Juventus-Technikerschule-HF/EduboardV2_Baseboard/3DModel/Eduboard2_CPUClip_V3.stl

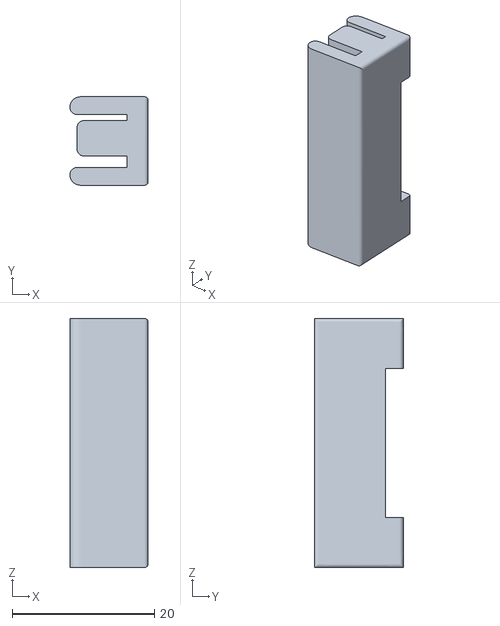
[picture p1: CAD file, 2023-07-14]
3DModel/Eduboard2_CPUClip_V3.stl
11.0 x 12.5 x 35.0
