Juventus-Technikerschule-HF/EduboardV2_Baseboard/3DModel/Eduboard2_CPUClamp1_V1.stl

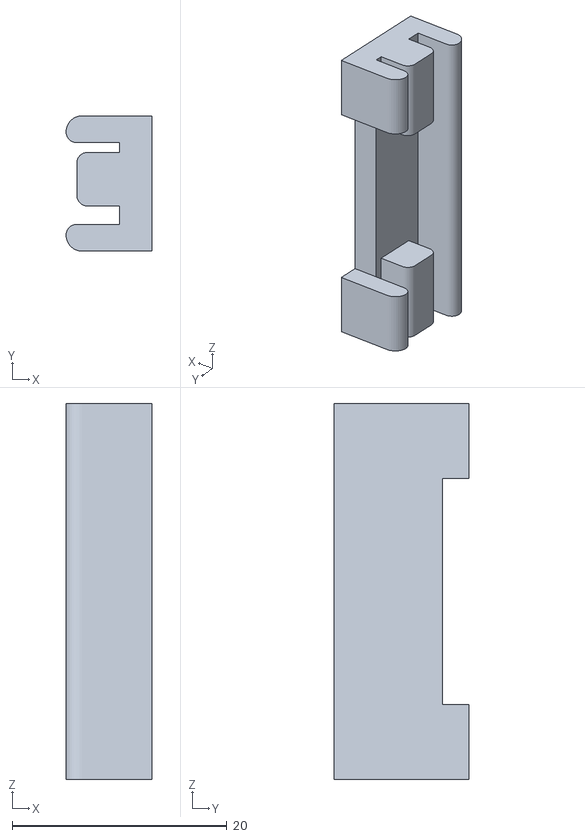
[picture p2: CAD file, 2023-07-14]
3DModel/Eduboard2_CPUClamp1_V1.stl
8.00 x 12.6 x 35.0
