Juventus-Technikerschule-HF/EduboardV2_Baseboard/3DModel/Edubaord2_CPUClip_V2.stl

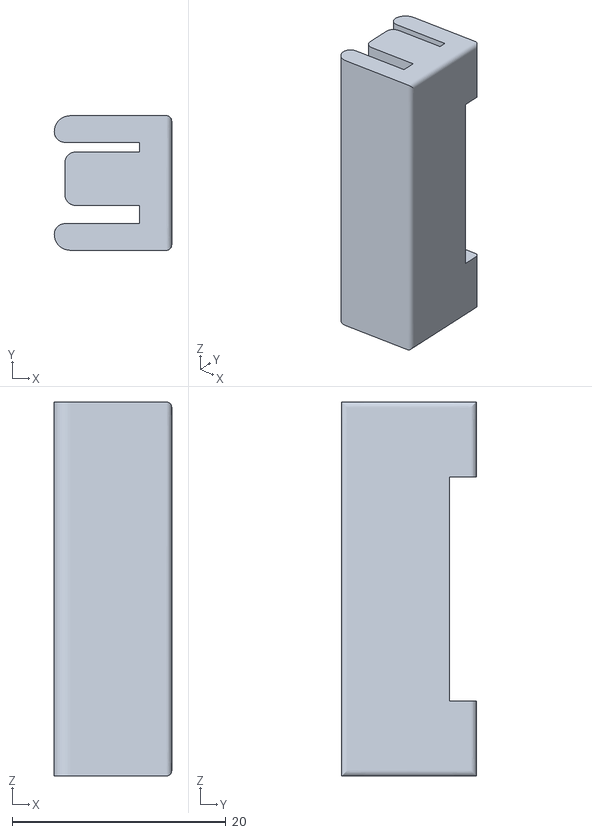
[picture p3: CAD file, 2023-07-14]
3DModel/Edubaord2_CPUClip_V2.stl
11.0 x 12.6 x 35.0
