Juventus-Technikerschule-HF/EduboardV2_Baseboard/3DModel/Eduboard2_Display3.5Clip_V2.stl

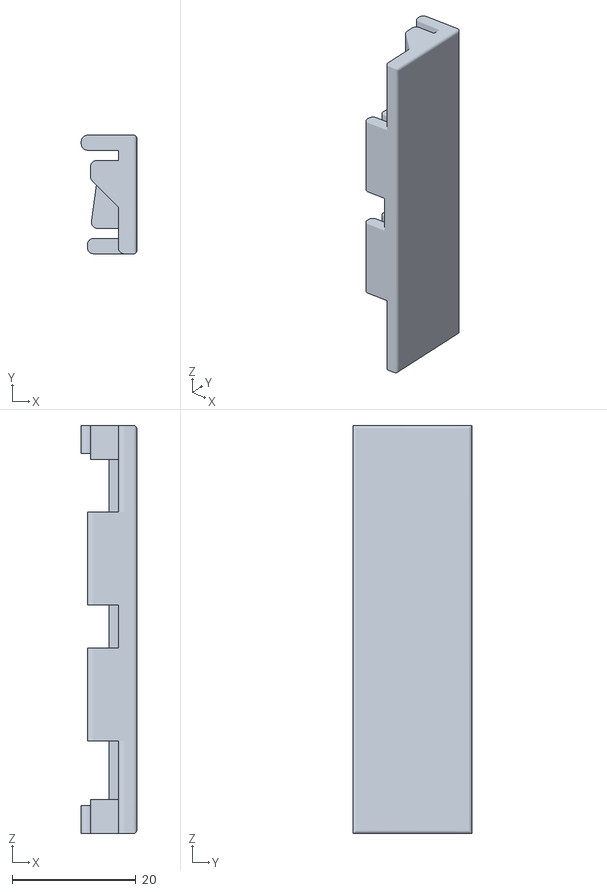
[picture p4: CAD file, 2023-07-14]
3DModel/Eduboard2_Display3.5Clip_V2.stl
9.00 x 19.2 x 66.0
