Juventus-Technikerschule-HF/EduboardV2_Baseboard/3DModel/Eduboard_Adapter.step

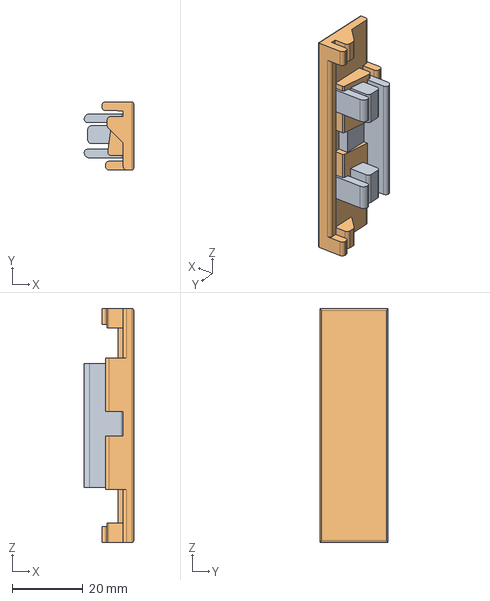
[picture p5: CAD file, 2023-07-14]
3DModel/Eduboard_Adapter.step
14.0 x 19.2 x 66.0 mm
CPUClip
Display3.5Clip
