Juventus-Technikerschule-HF/EduboardV2_Baseboard/3DModel/Eduboard2_Display3.5Clip_V1.stl

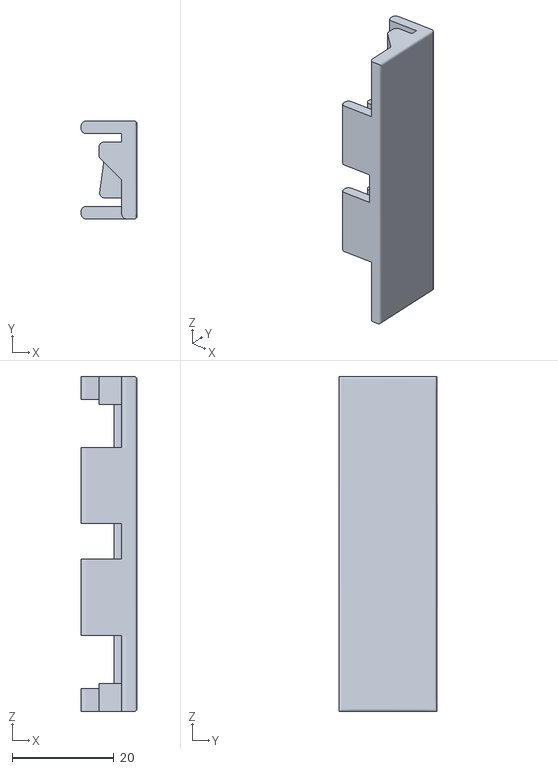
[picture p6: CAD file, 2023-07-14, an earlier design]
3DModel/Eduboard2_Display3.5Clip_V1.stl
11.0 x 19.3 x 66.0
