Juventus-Technikerschule-HF/EduboardV2_Baseboard/usbhub.kicad_sch

## KiCad design usbhub.kicad_sch (2024-07-12, an earlier design)

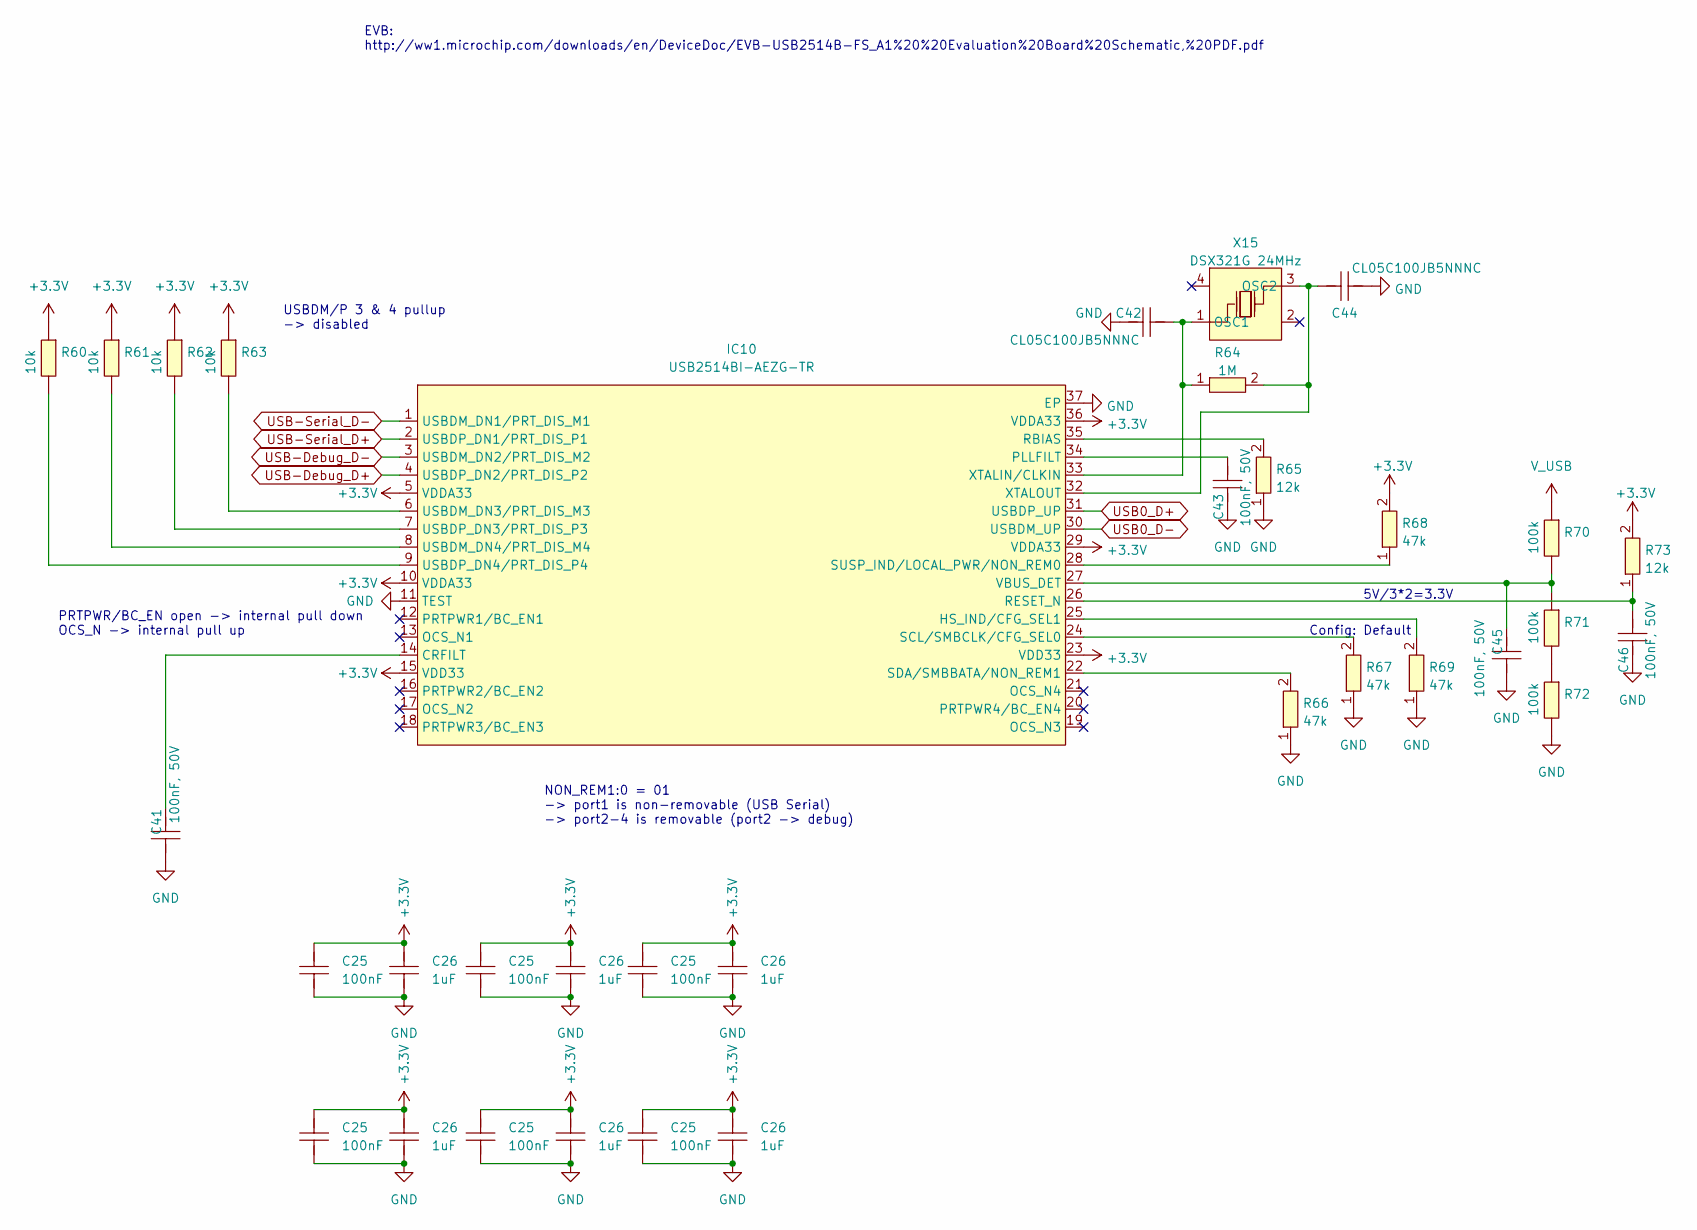
[picture p7: schematic usbhub.kicad_sch]

Parts:
C25: 100nF; C_0402_1005Metric_Pad0.74x0.62mm_HandSolder; MPN CL05B104KB54PNC; LCSC Part C307331
C26: 1uF; C_0402_1005Metric_Pad0.74x0.62mm_HandSolder; MPN CL05A105KA5NQNC; LCSC Part C52923
C41, C43, C45, C46: 100nF, 50V; C_0402_1005Metric_Pad0.74x0.62mm_HandSolder; MPN CL05B104KB54PNC; LCSC Part C307331
C42, C44: CL05C100JB5NNNC; C_0402_1005Metric_Pad0.74x0.62mm_HandSolder; MPN CL05C100JB5NNNC; LCSC Part C32949
IC10: USB2514BI-AEZG-TR; TQFN-36_L6.0-W6.0-P0.50-BL-EP3.7; MPN USB2514BI-AEZG-TR; LCSC Part C58940
R60, R61, R62, R63: 10k; R_0402_1005Metric_Pad0.72x0.64mm_HandSolder; MPN 0402WGF1002TCE; LCSC Part C25744
R64: 1M; R_0402_1005Metric_Pad0.72x0.64mm_HandSolder; LCSC Part C25741
R65, R73: 12k; R_0402_1005Metric_Pad0.72x0.64mm_HandSolder; LCSC Part C25752
R66, R67, R68, R69: 47k; R_0402_1005Metric_Pad0.72x0.64mm_HandSolder; LCSC Part C25792
R70, R71, R72: 100k; R_0402_1005Metric_Pad0.72x0.64mm_HandSolder; MPN 0402WGF1003TCE; LCSC Part C25741
X15: DSX321G 24MHz; OSC-SMD_4P-L3.2-W2.5-BL; LCSC Part C93235

Connections:
+3.3V: C25.2, C26.2, IC10.5 (VDDA33), IC10.10 (VDDA33), IC10.15 (VDD33), IC10.23 (VDD33), IC10.29 (VDDA33), IC10.36 (VDDA33), R60.1, R61.1, R62.1, R63.1, R68.2, R73.2
GND: C25.1, C26.1, C41.2, C42.1, C43.2, C44.2, C45.2, C46.2, IC10.11 (TEST), IC10.37 (EP), R65.1, R66.1, R67.1, R69.1, R72.2
unnamed: C41.1, IC10.14 (CRFILT)
unnamed: C42.2, IC10.33 (XTALIN/CLKIN), R64.1, X15.1 (OSC1)
unnamed: C43.1, IC10.34 (PLLFILT)
unnamed: C44.1, IC10.32 (XTALOUT), R64.2, X15.3 (OSC2)
unnamed: C45.1, IC10.27 (VBUS_DET), R70.2, R71.1
unnamed: C46.1, IC10.26 (RESET_N), R73.1
unnamed: IC10.6 (USBDM_DN3/PRT_DIS_M3), R63.2
unnamed: IC10.7 (USBDP_DN3/PRT_DIS_P3), R62.2
unnamed: IC10.8 (USBDM_DN4/PRT_DIS_M4), R61.2
unnamed: IC10.9 (USBDP_DN4/PRT_DIS_P4), R60.2
unnamed: IC10.22 (SDA/SMBBATA/NON_REM1), R66.2
unnamed: IC10.24 (SCL/SMBCLK/CFG_SEL0), R67.2
unnamed: IC10.25 (HS_IND/CFG_SEL1), R69.2
unnamed: IC10.28 (SUSP_IND/LOCAL_PWR/NON_REM0), R68.1
unnamed: IC10.35 (RBIAS), R65.2
unnamed: R71.2, R72.1
USB0_D+: IC10.31 (USBDP_UP)
USB0_D-: IC10.30 (USBDM_UP)
USB-Debug_D+: IC10.4 (USBDP_DN2/PRT_DIS_P2)
USB-Debug_D-: IC10.3 (USBDM_DN2/PRT_DIS_M2)
USB-Serial_D+: IC10.2 (USBDP_DN1/PRT_DIS_P1)
USB-Serial_D-: IC10.1 (USBDM_DN1/PRT_DIS_M1)
V_USB: R70.1

Notes on the sheet:
PRTPWR/BC_EN open -> internal pull down OCS_N -> internal pull up
EVB: http://ww1.microchip.com/downloads/en/DeviceDoc/EVB-USB2514B-FS_A1%20%20Evaluation%20Board%20Schematic,%20PDF.pdf
5V/3*2=3.3V
Config: Default
USBDM/P 3 & 4 pullup -> disabled
NON_REM1:0 = 01 -> port1 is non-removable (USB Serial) -> port2-4 is removable (port2 -> debug)
