Juventus-Technikerschule-HF/EduboardV2_Baseboard/(threads)

Thread 3 (2022-06-07):

Move USB Serial Converter and USB Connector from Power Page to Page5 / Page 6

mburger82, 2022-06-07:
CH340 needs to move to Page 6 (interfaces).
USB Connector may be a point to discuss...

mburger82, 2022-06-11:
10b4307024bcba9a6965f9aedea9f77992894b67

Closed 2022-06-11.

Thread 4 (2022-06-07):

replace 5V selector with more fancy (less Voltage drop) circuit

mburger82, 2022-06-07:
Maybe something like this?
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

mburger82, 2022-06-11:
done in 4a000bc18bebc424a0765db95a3bd588f8fbd9e8

Closed 2022-06-11.

Thread 8 (2022-06-07):

Add Ouput Connector to WS2812 Dout

mburger82, 2022-06-07:
5V-Data-GND
Simple 2.54mm 3Pin Solderpads

mburger82, 2022-06-11:
done in 10d15726495d8792da39d1d4b9824ec2d829a732

Closed 2022-06-11.

Thread 11 (2022-06-11):

Switch out +3.3V, +5V, +5V_EXT, V_EXT, V_USB and GND Symbols to References. Otherwise they dont connect the nets.

mburger82, 2022-06-11:

mburger82, 2022-06-11:
Hm, strange. As far as I can see the Symbols should be Correct...
Have to investigate further.

mburger82, 2022-06-11:
fixed in f38e4da2e638162e9049911122649460d996020f

Power References have to be Power-Input Pins. Power-Output does not connect them under one Net-Signal

Closed 2022-06-11.

Thread 14 (2023-05-13):

LCD Connector wrong way round

mburger82, 2023-05-13:
Pin1 -> Pin39
Pin2 -> Pin40

Drawing of LCD is upside down

Thread 15 (2023-05-13):

Thicken tracks for Power

mburger82, 2023-05-13:
Measurements of Voltage Regulators showed, they work very well. But over the length of the tracks the voltage gets lover up to 0.5V at higher currents. Need to thicken them and have multiple Vias on layer changes.

mburger82, 2023-06-22:
The automatic power selector seams to do something weird. Have to investigate.

mburger82, 2023-06-22:
Well... Voltage drop comes from mosfet RDSOn @ 80mOhm or so. At 1A this results in quite some Voltage.
Good enough!

Closed 2023-06-22.

Thread 16 (2023-05-13):

Need Pullups for CS Pins when no UP Board is present

mburger82, 2023-05-13:
When no UP-Board is present or the CS-Pins on the up-board are not configured, the cs Pins should be pulled high anyway to prevent reaction of any SPI Devices on board.

mburger82, 2023-05-28:
Also add pulldowns for pwm channels

mburger82, 2023-06-20:
done in 92582a20dd4010fd6c4107caee330f88c9490ec5 and f3cb5bdc9a72a360fb9439e9020d9e4d49971171

Closed 2023-06-20.

Thread 19 (2023-05-18):

Add DAC unit connected to SPI or I2C to achive basic DAC Options. Possibly multiple outputs

mburger82, 2023-05-18:
I2S is not really an option, because it uses all the GPIOX Pins

mburger82, 2023-05-18:
Could use DAC5571IDBVR (LCSC: C24061)
8Bit I2C DAC capable up to 188 ksps @ 3.4MBit I2C Rate

mburger82, 2023-06-20:
added in 9fb1e6c

Closed 2023-06-20.

Thread 20 (2023-05-18):

Change Holesize of Pads in X6 to something more reasonable like 1mm

mburger82, 2023-05-18:
also probably make pads larger...

mburger82, 2023-06-20:
fix in 5945c712176ba1562dcde1205969f2bf0daca017

Closed 2023-06-20.

Thread 21 (2023-05-18):

Lower I2C Pullups

mburger82, 2023-05-18:
10k Pullups for I2C are way too high for such long lines and so many slaves. Have to lower it to a max of 1k probably.
Have to test that first.

mburger82, 2023-05-27:
1k is way better.
Also change T7 and T8 to BSN20. Way lower Capacitance, which was the main Problem beforehand.
With 1k and BSN20 the Temperature Sensor is working up to 1MHz

mburger82, 2023-06-20:
fixed in 425ff3c

Closed 2023-06-20.

Thread 23 (2023-05-28):

UP Connector 3.3V and 5V need Ideal Diodes to prevent powering from the UP Board when SW1 is off

mburger82, 2023-05-28:

mburger82, 2023-05-29:
Probably not nescessary if no USB is placed on the UP Board at all. Maybe the better option!

mburger82, 2023-06-20:
Not nescessary. USB Connectors on UPBoard should not be present, so not nescessary.

Closed 2023-06-20.

Thread 24 (2023-05-29):

Maybe turn around SW1 90deg to prevent Shipping problems from Prototypes

mburger82, 2023-05-29:

mburger82, 2023-06-22:
done in 33dacbfd15503772adc866fcdd3823dfb586aeab

Closed 2023-06-22.

Thread 25 (2023-07-13):

Move DAC closer to UP or I2C Pullups closer to DAC.

mburger82, 2023-07-13:
If higher I2C Clocks should be achieveable, the capacitive load on the i2c line should be minimized and the length to the dac schould be minimized. Also moving the I2C Pullups closer to the DAC could help.
Maybe make Level-Shifter detachable (Solder Jumpers or somthing like that) to detach cpacity of Level Shifter.

mburger82, 2023-10-30:
obsolete. Replaced with SPI Variant
853b78f0c907125e6715c78b12bc7a0b2f8ac236

Closed 2023-10-30.

Thread 26 (2023-07-13):

DAC5571 is nice and all, but SPI would be way faster!

mburger82, 2023-07-13:
Maybe use MCP4802.
CS could be shared with flash or GPIOX3/4, selectable via solder jumper. Flash is normally not nescessary...
This solution would be very much faster and probably easier to automate with dma?
And the device has 2 DAC Channels built in!
IC costs 2.3$
2x DAC5571 costs 2 x 1.0055$
so no big difference!

mburger82, 2023-10-30:
done in 853b78f0c907125e6715c78b12bc7a0b2f8ac236

Closed 2023-10-30.

Thread 30 (2024-07-15):

Flash Chip interferes with LCD SPI

mburger82, 2024-07-15:
Have to further investigate.
LCD always works, Flash Chip only works if LCD is not connected and LCD Driver is not activated or Flash comes first in Init. (Not yet tested if it only works on init time before lcd is initialized...)

mburger82, 2024-07-18:
Probably FONT_CS &| FLASH_CS &| SD_CS which are not correct let one of the three things on the display interfere with the SPI-Interface.
Pullups on the Pins would fix that probably
