Juventus-Technikerschule-HF/EduboardV2_Baseboard/(commit log)

2022-06-05 initial commit. setup base-structure
    [EduboardV2_Baseboard.kicad_pcb, EduboardV2_Baseboard.kicad_sch, connectors.kicad_sch, display_ui.kicad_sch, power.kicad_sch, sensors_interfaces.kicad_sch, up_rtc_flash.kicad_sch]
2022-06-05 add comments/todos for each schematics page
    [EduboardV2_Baseboard.kicad_pcb, EduboardV2_Baseboard.kicad_sch, connectors.kicad_sch, display_ui.kicad_sch, power.kicad_sch, sensors_interfaces.kicad_sch, up_rtc_flash.kicad_sch]
2022-06-05 add kicad_prl file anyway, seams to have important info in it.
2022-06-06 updated library, partly created power.kicad_sch
    [EduboardV2_Baseboard.kicad_pcb, EduboardV2_Baseboard.kicad_sch, power.kicad_sch, up_rtc_flash.kicad_sch]
2022-06-06 nearly finished display_ui.kicad_sch and power.kicad_sch
    [EduboardV2_Baseboard.kicad_sch, display_ui.kicad_sch, power.kicad_sch]
2022-06-06 added diode
2022-06-06 added up_rtc_flash.kicad_sch and finished others
    [EduboardV2_Baseboard.kicad_sch, connectors.kicad_sch, display_ui.kicad_sch, power.kicad_sch, sensors_interfaces.kicad_sch, up_rtc_flash.kicad_sch]
2022-06-06 added more components
    [EduboardV2_Baseboard.kicad_pcb, EduboardV2_Baseboard.kicad_sch, connectors.kicad_sch, display_ui.kicad_sch, power.kicad_sch, sensors_interfaces.kicad_sch, up_rtc_flash.kicad_sch]
2022-06-07 beautified the library
    [connectors.kicad_sch, display_ui.kicad_sch, power.kicad_sch, sensors_interfaces.kicad_sch, up_rtc_flash.kicad_sch]
2022-06-07 merged libraries and beautified the last symbols
    [connectors.kicad_sch, display_ui.kicad_sch, power.kicad_sch, sensors_interfaces.kicad_sch, up_rtc_flash.kicad_sch]
2022-06-07 fixed RTC Symbol
    [EduboardV2_Baseboard.kicad_pcb, connectors.kicad_sch, power.kicad_sch, up_rtc_flash.kicad_sch]
2022-06-07 Rough pcb placement for space estimation. Exchanged 40P connector
    [EduboardV2_Baseboard.kicad_pcb, EduboardV2_Baseboard.kicad_sch, connectors.kicad_sch, power.kicad_sch]
2022-06-07 slight modifications
    [EduboardV2_Baseboard.kicad_pcb]
2022-06-08 changed pin types and fixed 3D-positions
    [EduboardV2_Baseboard.kicad_pcb, connectors.kicad_sch, display_ui.kicad_sch, power.kicad_sch, sensors_interfaces.kicad_sch, up_rtc_flash.kicad_sch]
2022-06-09 change all local labels to global labels.
    [connectors.kicad_sch, display_ui.kicad_sch, power.kicad_sch, sensors_interfaces.kicad_sch, up_rtc_flash.kicad_sch]
2022-06-10 positioned components. Exchanged battery holder
    [EduboardV2_Baseboard.kicad_pcb, EduboardV2_Baseboard.kicad_sch, connectors.kicad_sch, power.kicad_sch, up_rtc_flash.kicad_sch]
2022-06-11 move USB Serial Converter and USB Connector to correct pages
    [EduboardV2_Baseboard.kicad_sch, connectors.kicad_sch, power.kicad_sch, sensors_interfaces.kicad_sch]
2022-06-11 move IMU to interfaces page
    [EduboardV2_Baseboard.kicad_sch, sensors_interfaces.kicad_sch, up_rtc_flash.kicad_sch]
2022-06-11 add USB ESD Protection
    [EduboardV2_Baseboard.kicad_sch, connectors.kicad_sch]
2022-06-11 add WS2812 Output Connector and add Level shifter to WS2812 input for 3.3V->5V conversion
    [EduboardV2_Baseboard.kicad_sch, connectors.kicad_sch, display_ui.kicad_sch]
2022-06-11 move Audio-Connectors to connectors page
    [EduboardV2_Baseboard.kicad_sch, connectors.kicad_sch, sensors_interfaces.kicad_sch]
2022-06-11 move RS485 Connector to connectors page
    [EduboardV2_Baseboard.kicad_sch, connectors.kicad_sch, sensors_interfaces.kicad_sch]
2022-06-11 add IRLML6402 P Channel Mosfet for more Power Capabilities
2022-06-11 change voltage selector
    [EduboardV2_Baseboard.kicad_sch, connectors.kicad_sch, power.kicad_sch]
2022-06-11 add stemma connector circuit
    [EduboardV2_Baseboard.kicad_sch, connectors.kicad_sch]
2022-06-11 fix Resistor Value for WS2812 level shifter
    [EduboardV2_Baseboard.kicad_sch, display_ui.kicad_sch]
2022-06-11 add I2C0 Pullups
    [EduboardV2_Baseboard.kicad_sch, up_rtc_flash.kicad_sch]
2022-06-11 reassign symbol references after page movements. Place in pcb
    [EduboardV2_Baseboard.kicad_pcb, EduboardV2_Baseboard.kicad_sch, connectors.kicad_sch, display_ui.kicad_sch, power.kicad_sch, sensors_interfaces.kicad_sch, up_rtc_flash.kicad_sch]
2022-06-11 fix power symbol problem.
    [EduboardV2_Baseboard.kicad_pcb, connectors.kicad_sch, display_ui.kicad_sch, power.kicad_sch, sensors_interfaces.kicad_sch, up_rtc_flash.kicad_sch]
2022-06-12 added rotary encoder
    [EduboardV2_Baseboard.kicad_pcb, EduboardV2_Baseboard.kicad_sch, connectors.kicad_sch, display_ui.kicad_sch]
2022-06-12 Fix hole not showing in 3d. THT holes had paste enabled.
    [EduboardV2_Baseboard.kicad_pcb, connectors.kicad_sch]
2022-06-12 add rotary encoder circuit
    [EduboardV2_Baseboard.kicad_sch, display_ui.kicad_sch]
2022-06-12 Fix Power Label Mess.
    Add Single Power_Output Symbol to each Power Network. All other Power-Labels are Power_Inputs.
    ERC now shows no Power_Output/Input Errors.
    [EduboardV2_Baseboard.kicad_pcb, EduboardV2_Baseboard.kicad_sch, connectors.kicad_sch, display_ui.kicad_sch, power.kicad_sch, sensors_interfaces.kicad_sch, up_rtc_flash.kicad_sch]
2022-06-18 change rotary encoder signals to Outputs
    [display_ui.kicad_sch]
2022-06-18 remove duplicate accelerometer
    [EduboardV2_Baseboard.kicad_sch, sensors_interfaces.kicad_sch]
2022-06-18 Add Global Signals to UP page.
    Audio Out missing,
    USB Debug / USB Direct missing
    [up_rtc_flash.kicad_sch]
2022-06-18 Something Something USB Connector?!
    [connectors.kicad_sch]
2022-06-19 Add 24MHz Quartz and some Resistors
2022-06-19 Add new Page for USB Hub circuit.
    [EduboardV2_Baseboard.kicad_sch, connectors.kicad_sch, sensors_interfaces.kicad_sch, up_rtc_flash.kicad_sch, usbhub.kicad_sch]
2023-03-14 migrate to kicad 7
    [EduboardV2_Baseboard.kicad_pcb, EduboardV2_Baseboard.kicad_sch, connectors.kicad_sch, display_ui.kicad_sch, power.kicad_sch, sensors_interfaces.kicad_sch, up_rtc_flash.kicad_sch, usbhub.kicad_sch]
2023-03-16 add tft touch controller info, work on mpcie pinout
    [connectors.kicad_sch, display_ui.kicad_sch]
2023-04-11 start rework of baseboard.
    [EduboardV2_Baseboard.kicad_pcb, connectors.kicad_sch, display_ui.kicad_sch, power.kicad_sch, sensors_interfaces.kicad_sch, up_rtc_flash.kicad_sch, usbhub.kicad_sch]
2023-04-16 rework schematic. remove unnescessary stuff. Connect PCIE Connector. Select new Temperature Sensor (I2C) Define Signals for 40Pin Connector
    [EduboardV2_Baseboard.kicad_sch, connectors.kicad_sch, display_ui.kicad_sch, sensors_interfaces.kicad_sch, up_rtc_flash.kicad_sch]
2023-04-16 replace display with better module, start layout parts on pcb.
    [EduboardV2_Baseboard.kicad_pcb, connectors.kicad_sch, display_ui.kicad_sch, power.kicad_sch, sensors_interfaces.kicad_sch, up_rtc_flash.kicad_sch, usbhub.kicad_sch]
2023-04-17 add protoboard area. not yet done
    [EduboardV2_Baseboard.kicad_pcb, connectors.kicad_sch]
2023-04-18 Layout of parts done. Started laying tracks
    [connectors.kicad_sch, display_ui.kicad_sch, power.kicad_sch, sensors_interfaces.kicad_sch, up_rtc_flash.kicad_sch, usbhub.kicad_sch]
2023-04-19 proceed with layout
    [connectors.kicad_sch, display_ui.kicad_sch, sensors_interfaces.kicad_sch, up_rtc_flash.kicad_sch]
2023-04-20 work on layout.
    [connectors.kicad_sch, display_ui.kicad_sch, sensors_interfaces.kicad_sch]
2023-04-20 layout done so far. Have to check everything again
    [bom.csv, connectors.kicad_sch, designators.csv, display_ui.kicad_sch, positions.csv, power.kicad_sch, sensors_interfaces.kicad_sch]
2023-04-21 fix parts (like led were wrong way round) Neatify Board
    [EduboardV2_Baseboard.kicad_pcb, connectors.kicad_sch, display_ui.kicad_sch, power.kicad_sch]
2023-04-23 finalize baseboard. finishing touches
    [EduboardV2_Baseboard.kicad_pcb, connectors.kicad_sch]
2023-04-24 remove some part designators from silkscreen
    [EduboardV2_Baseboard.kicad_pcb]
2023-04-25 ready for order first prototype
    [EduboardV2_Baseboard.kicad_pcb, bom.csv, connectors.kicad_sch, designators.csv, display_ui.kicad_sch, positions.csv]
2023-05-15 mark errors found on first prototypes
    [connectors.kicad_sch, display_ui.kicad_sch, power.kicad_sch]
2023-06-20 fix some wrong jlcpcb part numbers
    [connectors.kicad_sch, display_ui.kicad_sch, usbhub.kicad_sch]
2023-06-20 add 2x DAC and fix I2C Impedance and Level Shifter
    [connectors.kicad_sch, sensors_interfaces.kicad_sch]
2023-06-20 fix X6 holesize to 1mm. also make pads a bit larger
    [EduboardV2_Baseboard.kicad_pcb]
2023-06-20 change ws2812 level shifter to bsn20
    [connectors.kicad_sch, display_ui.kicad_sch]
2023-06-20 change version to 2.1
    [EduboardV2_Baseboard.kicad_pcb]
2023-06-20 replace some parts (levelshifter) and add dac's
    [EduboardV2_Baseboard.kicad_pcb]
2023-06-20 add dac signals to protoboard part
    [connectors.kicad_sch]
2023-06-20 add GND-Pin for convenience
    [connectors.kicad_sch]
2023-06-20 add pullup resistors to cs pins and change dac pins to gpiox0 and 1 (AN0 is connected to pot)
    [connectors.kicad_sch, up_rtc_flash.kicad_sch]
2023-06-20 set pwm channels to pull down
    [up_rtc_flash.kicad_sch]
2023-06-22 rotate power switch 90degrees to prevent damage in shipping process
2023-06-22 change power switch fets to IRLML6402 and 2N7002
    [connectors.kicad_sch, power.kicad_sch]
2023-06-22 Redo gnd layer and gnd via stitching
2023-06-22 add some part alternatives and create production data
    [bom.csv, connectors.kicad_sch, designators.csv, display_ui.kicad_sch, positions.csv, usbhub.kicad_sch]
2023-06-25 Sort out RX/TX problems, improve DAC Circuits, Improve Board Text, switch out certain solder-jumpers with resistors
    [connectors.kicad_sch, display_ui.kicad_sch, power.kicad_sch, sensors_interfaces.kicad_sch, up_rtc_flash.kicad_sch]
2023-06-25 finalize data v2.1.
    [bom.csv, connectors.kicad_sch, designators.csv, display_ui.kicad_sch, positions.csv]
2023-06-26 Finalize Data and order V2.1
    [bom.csv, connectors.kicad_sch]
2023-06-27 add alternative for buzzer
    [connectors.kicad_sch, display_ui.kicad_sch]
2023-07-13 Add CPU and Display Clip 3D Models
    [Edubaord2_CPUClip_V2.stl, Eduboard2_CPUClamp1_V1.stl, Eduboard2_Display3.5Clip_V1.stl, Eduboard_Adapter.step]
2023-07-13 add new version of cpu and display clips
    [Eduboard2_CPUClip_V3.stl, Eduboard2_Display3.5Clip_V2.stl, Eduboard_Adapter.step]
2023-07-14 add display alternatives
    [connectors.kicad_sch, display_ui.kicad_sch]
2023-10-30 replace DAC with SPI Variant. Set Version to 2.2
    [connectors.kicad_sch, display_ui.kicad_sch, sensors_interfaces.kicad_sch, up_rtc_flash.kicad_sch]
2024-07-12 migrate to kicad version 8. Add some alternative part numbers
    [EduboardV2_Baseboard.kicad_sch, bom.csv, connectors.kicad_sch, designators.csv, display_ui.kicad_sch, positions.csv, power.kicad_sch, sensors_interfaces.kicad_sch]
2024-07-13 add alternative parts
    [connectors.kicad_sch]
